marmch/Tetris/unnamed.jpg

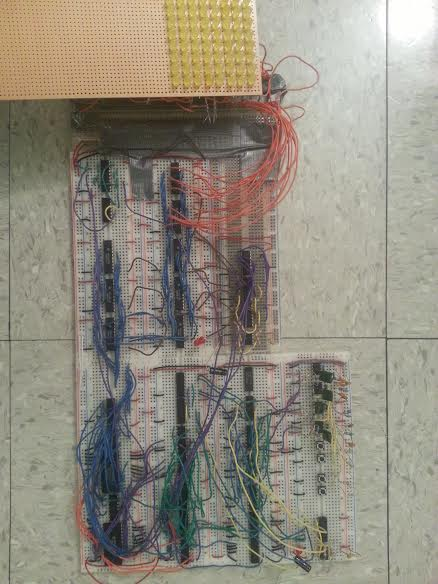
unnamed.jpg
