marmch/Tetris/input_logic.png

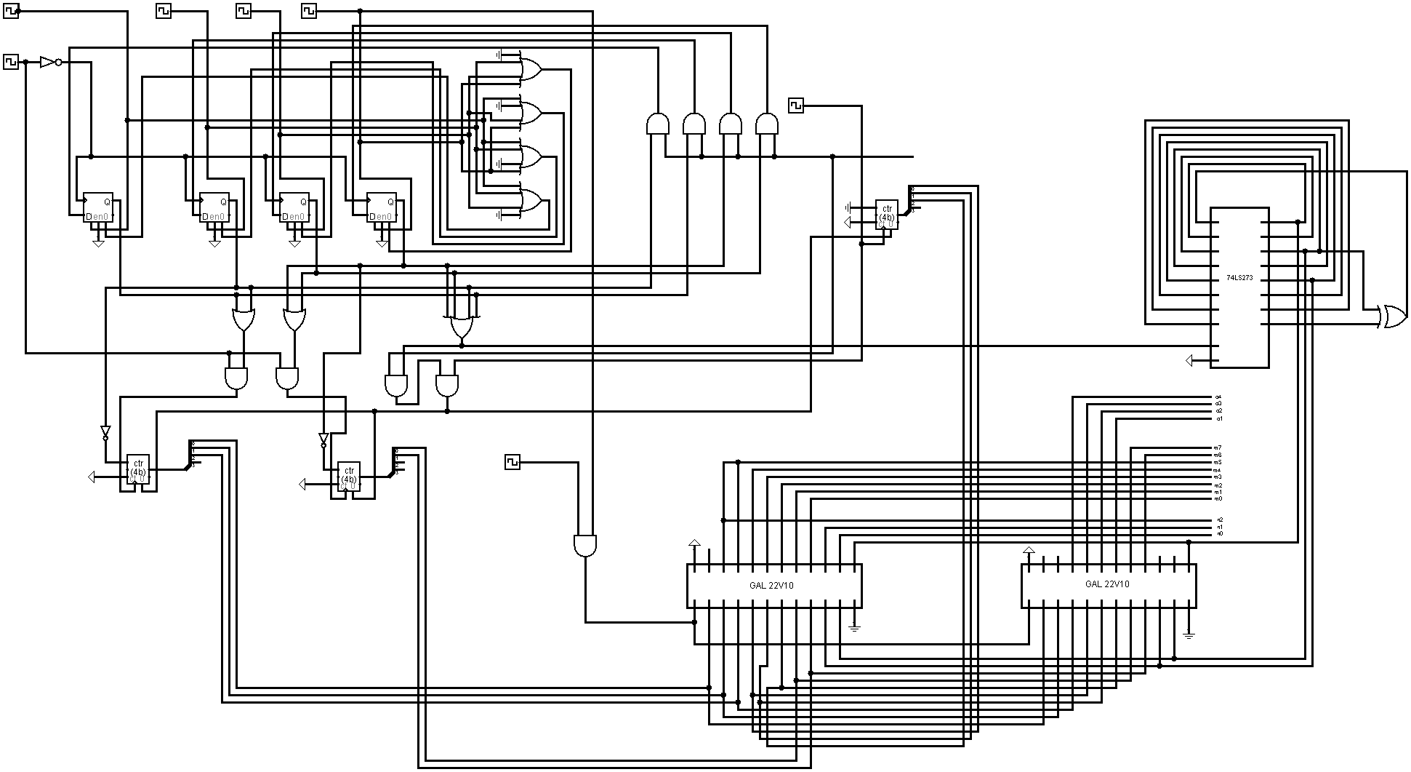
input_logic.png
