marmch/Tetris/input_sch.bmp

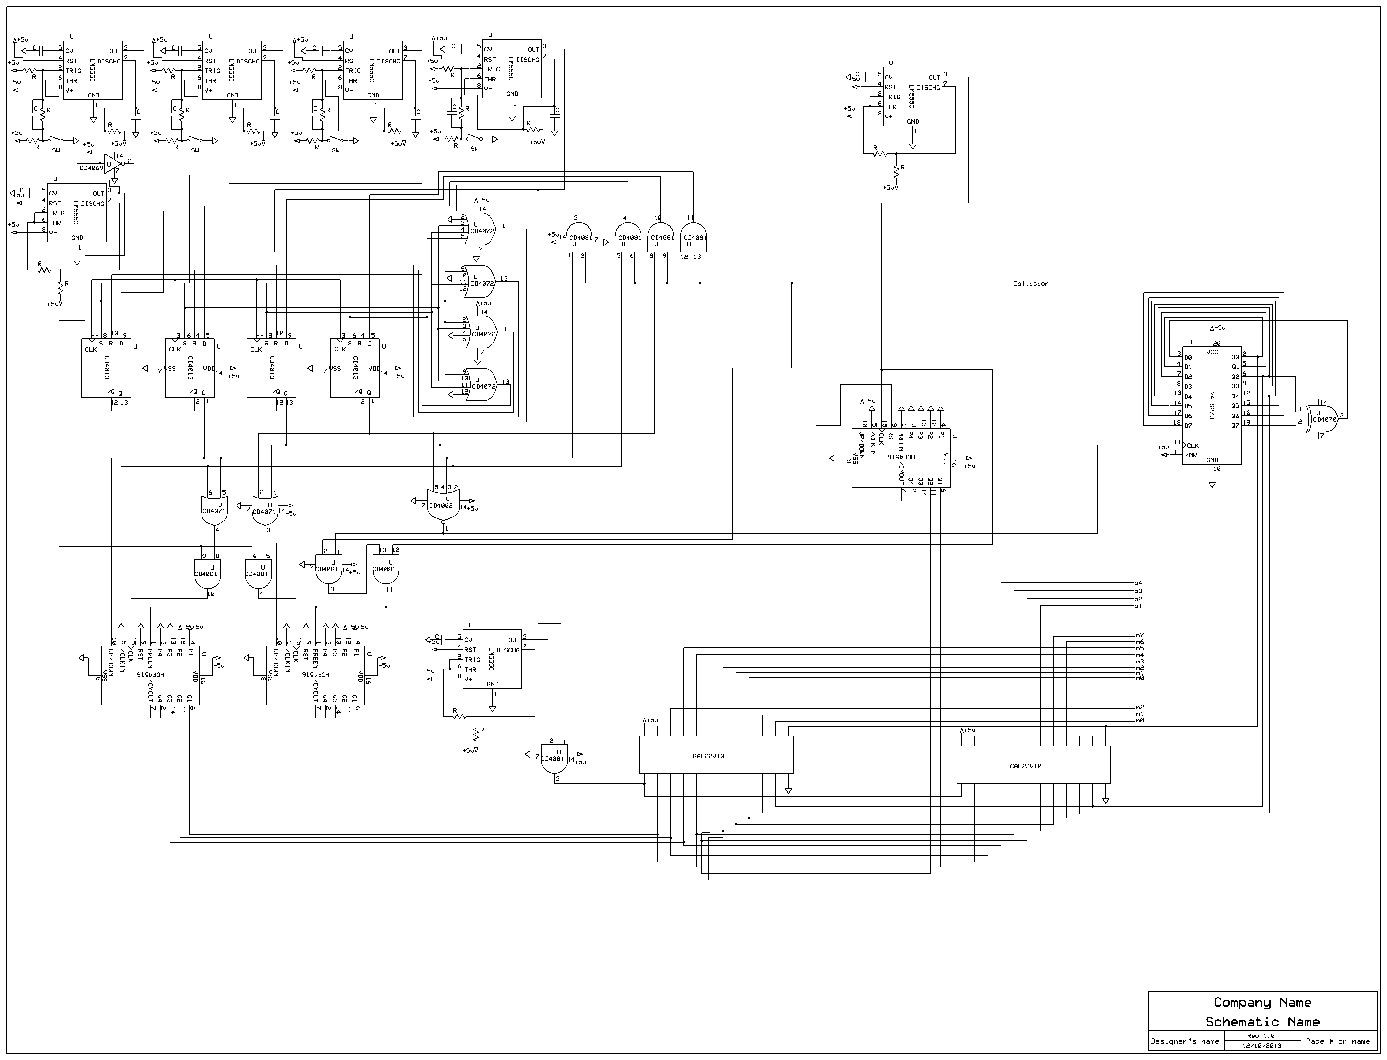
input_sch.bmp
