marmch/Tetris/output_logic.png

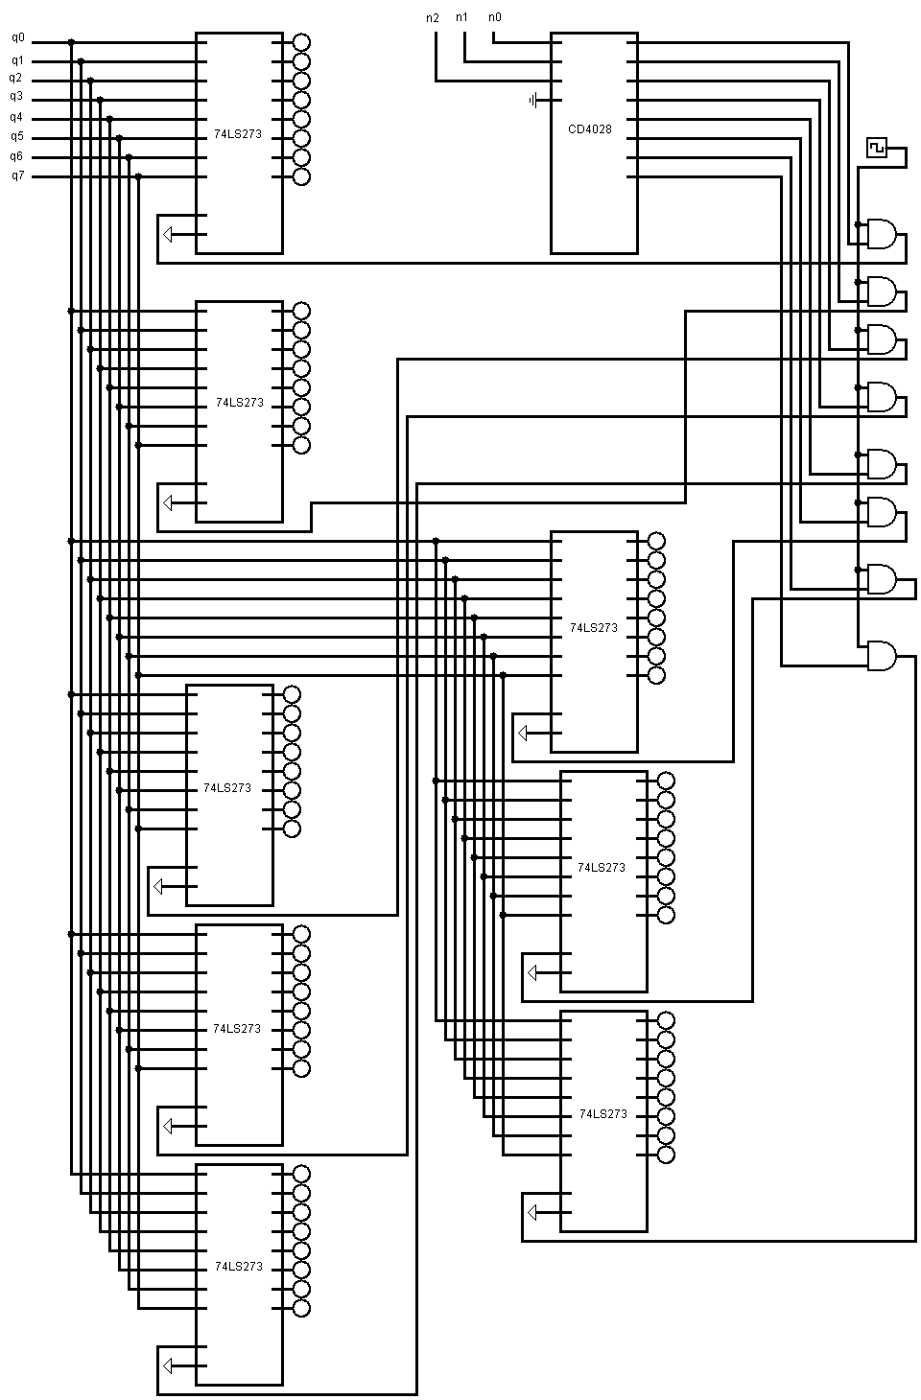
output_logic.png
