marmch/Tetris/output_sch.bmp

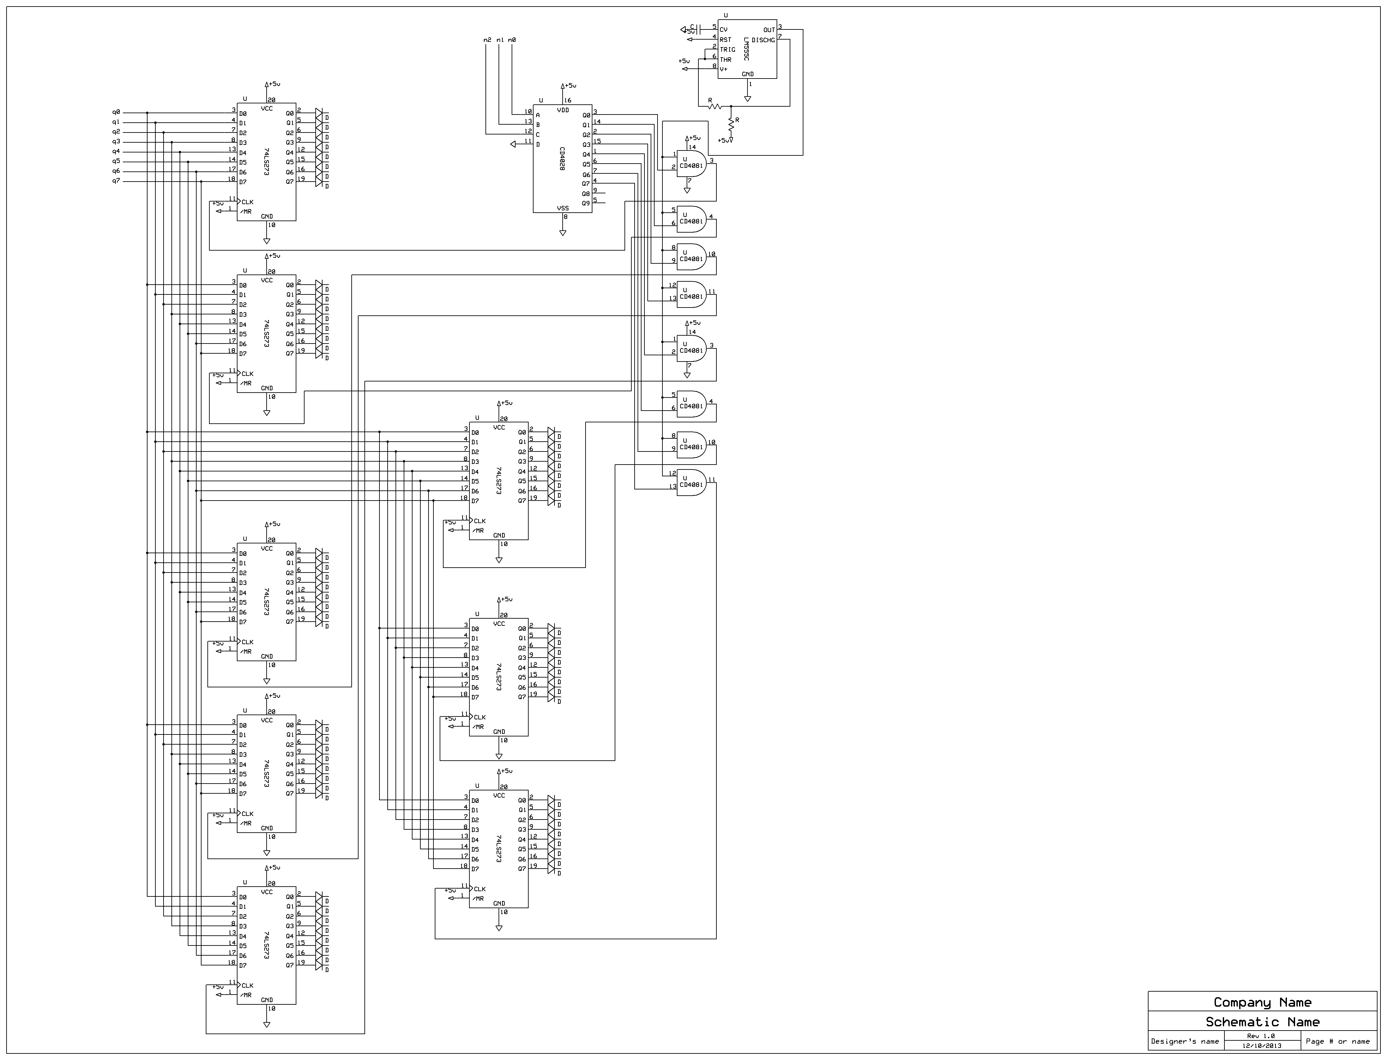
output_sch.bmp
