marmch/Tetris/RAM_logic.png

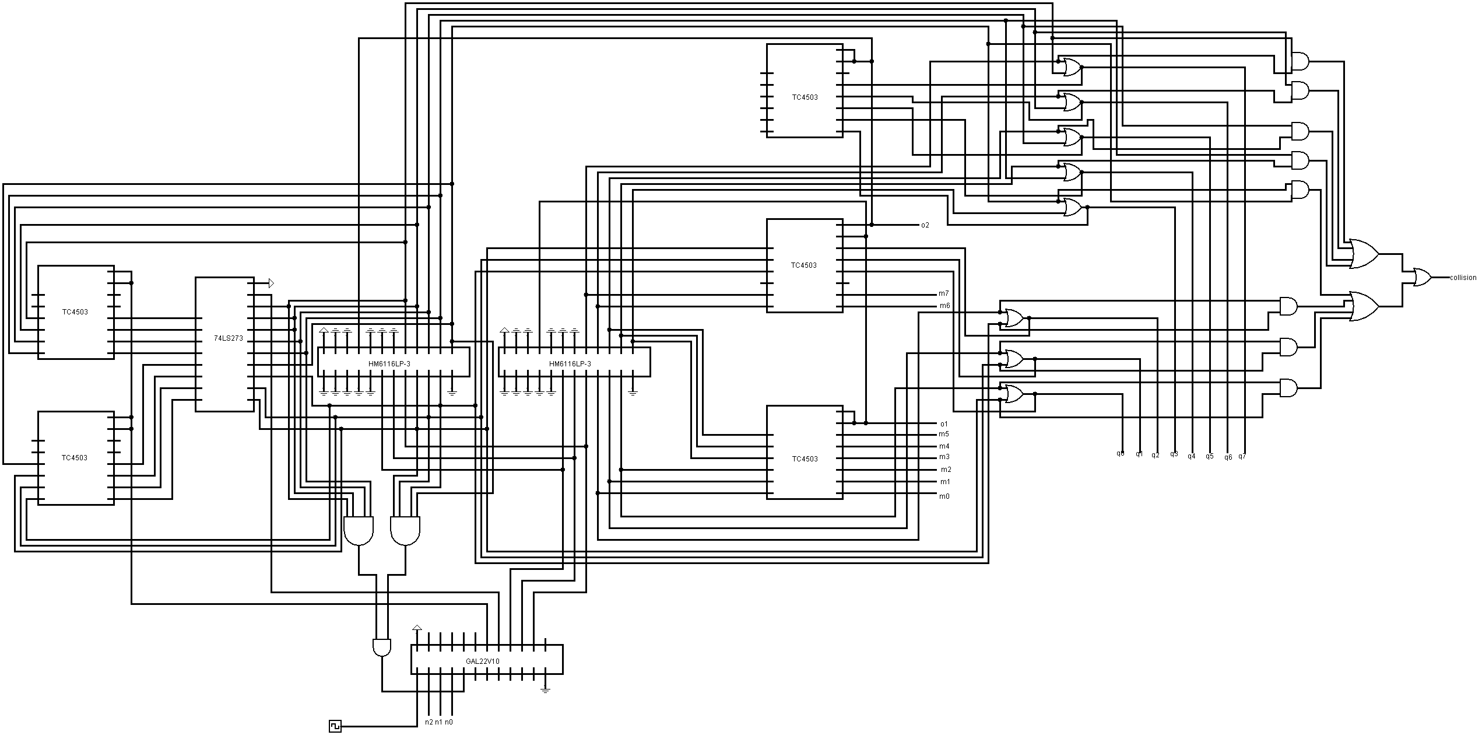
RAM_logic.png
