marmch/Tetris/RAM_sch.bmp

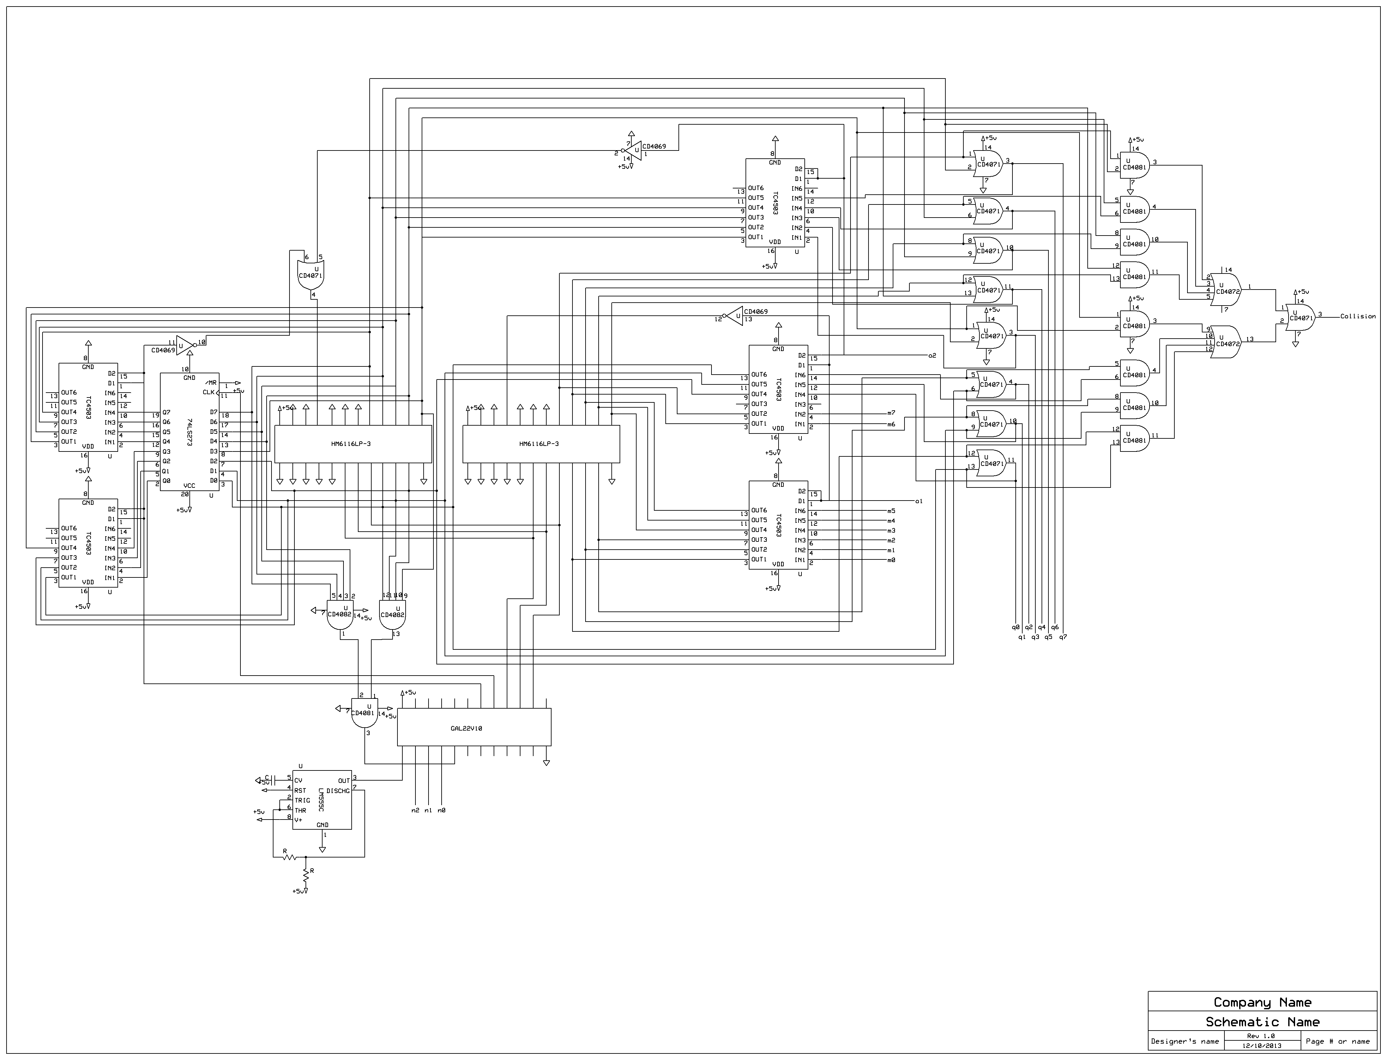
RAM_sch.bmp
