marmch/Tetris/(list of files, drawings)

Other design files:
Logic Diagram 1.circ
Logic Diagram 2.circ
Logic Diagram 3.circ
